Marcos-vp/TFG/Partes/Garra/Garra.FCStd

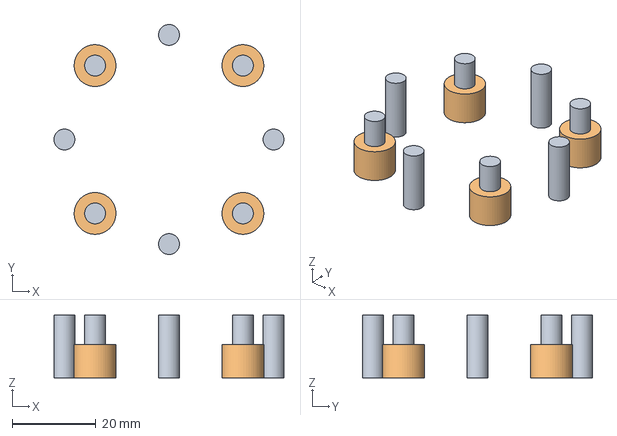
[picture p88: CAD file, 2018-09-13]
Partes/Garra/Garra.FCStd
55.0 x 55.0 x 15.0 mm
Taladro001
Taladrogrande001
