Marcos-vp/TFG/Partes/gear_for_servo.STL

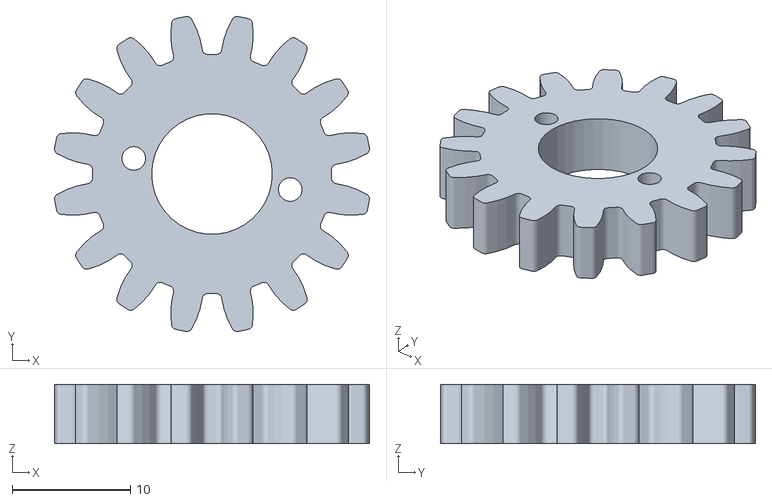
[picture p89: CAD file, 2018-09-18]
Partes/gear_for_servo.STL
26.7 x 26.7 x 5.00
