Marcos-vp/TFG/Partes/pinza 2/pinza2.FCStd

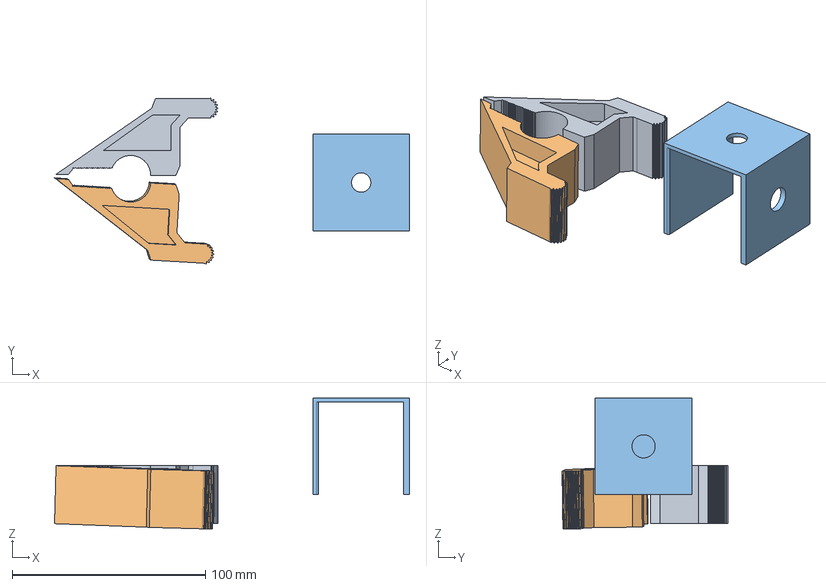
[picture p90: CAD file, 2018-09-13]
Partes/pinza 2/pinza2.FCStd
183.6 x 85.8 x 67.7 mm
Mirror of Pocket
