Marcos-vp/TFG/Partes/Pinza basica/agarre.stl

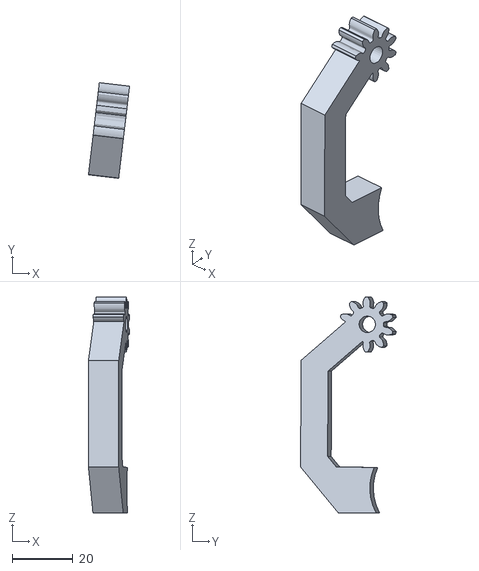
[picture p91: CAD file, 2018-10-14]
Partes/Pinza basica/agarre.stl
13.5 x 31.4 x 70.9
