Marcos-vp/TFG/Partes/Pinza final/union1.stl

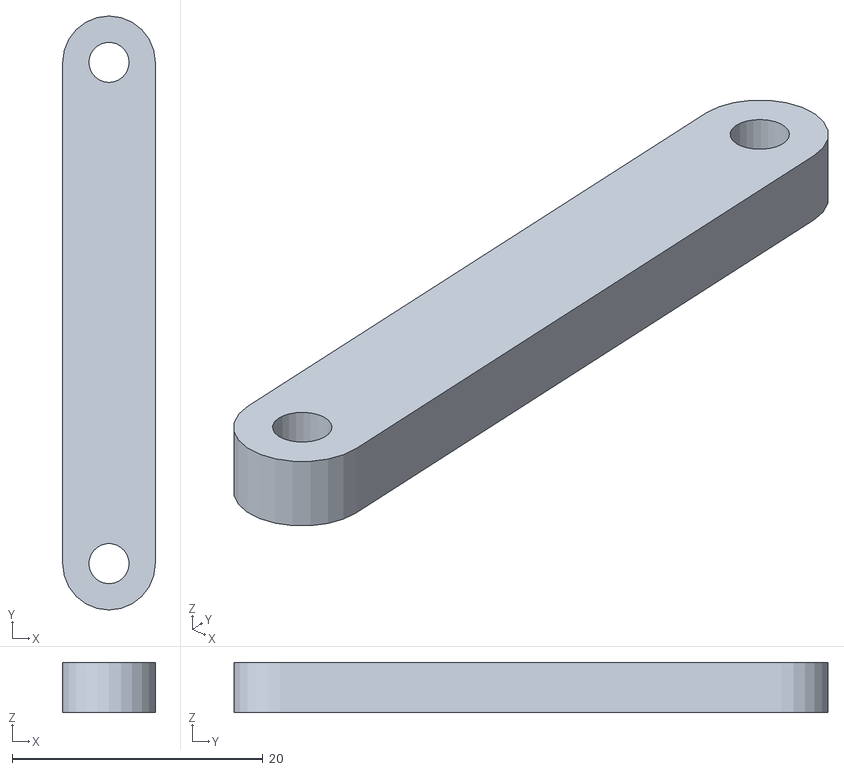
[picture p92: CAD file, 2019-10-01]
Partes/Pinza final/union1.stl
7.40 x 47.4 x 4.00
