Marcos-vp/TFG/Partes/Pinza basica/caja motor y enganche.stl

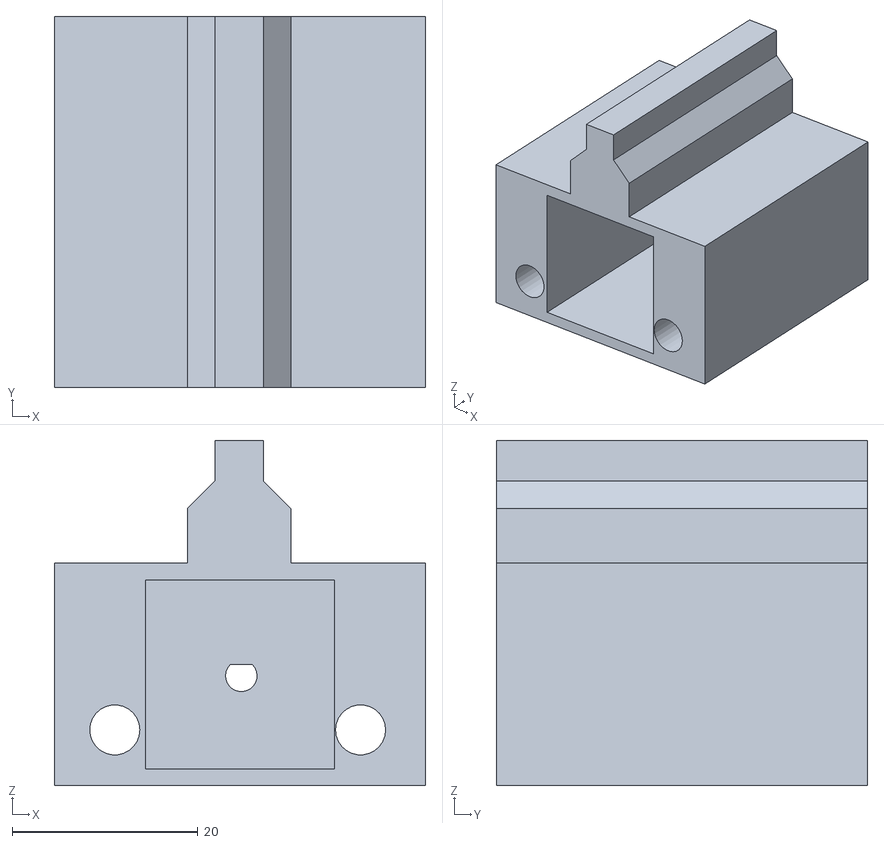
[picture p93: CAD file, 2018-10-14]
Partes/Pinza basica/caja motor y enganche.stl
40.0 x 40.0 x 37.2
