Marcos-vp/TFG/Partes/Pinza final/bridafinal.stl

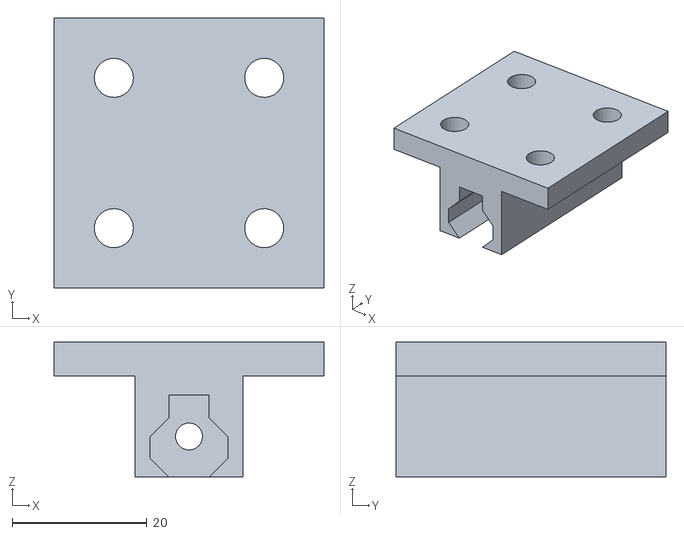
[picture p94: CAD file, 2019-10-01]
Partes/Pinza final/bridafinal.stl
40.0 x 40.0 x 20.0
