Marcos-vp/TFG/Partes/Porta_Rotulador/Herramienta Rotulador_v5.FCStd

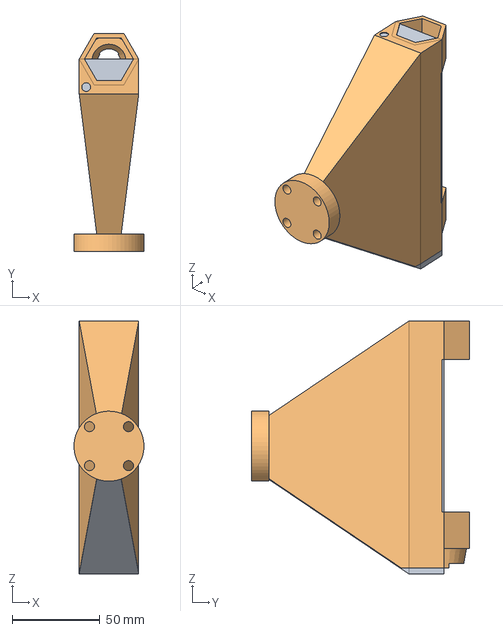
[picture p95: CAD file, 2019-06-30]
Partes/Porta_Rotulador/Herramienta Rotulador_v5.FCStd
40.0 x 124.7 x 144.5 mm
Final001
