Marcos-vp/TFG/Partes/Pinza basica/unión_brida.stl

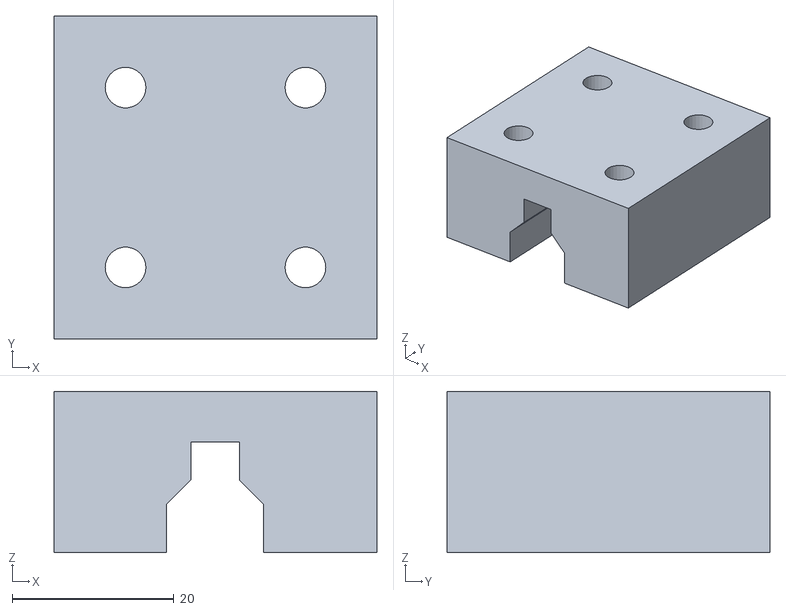
[picture p96: CAD file, 2018-10-14]
Partes/Pinza basica/unión_brida.stl
40.0 x 40.0 x 20.0
