Marcos-vp/TFG/Partes/Pinza final/cajamotor.FCStd

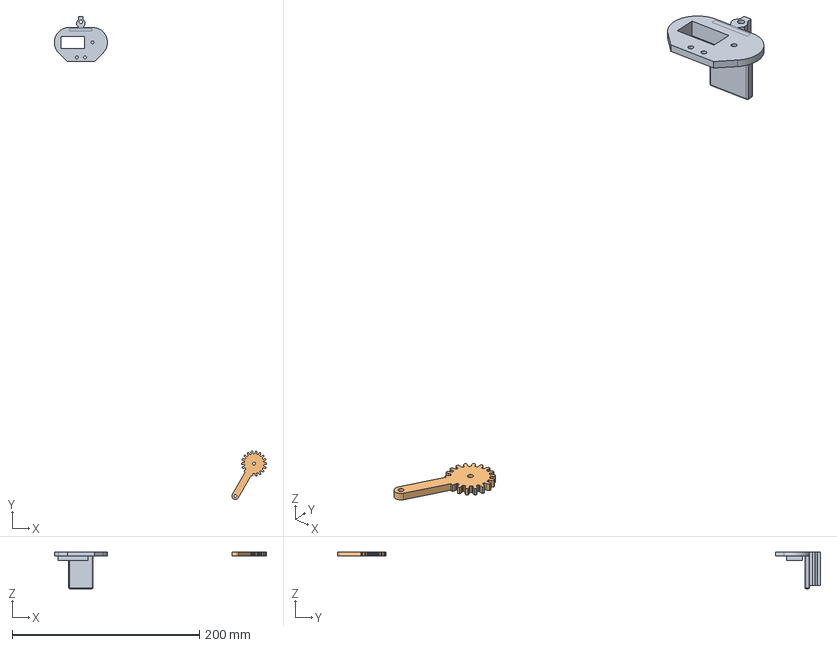
[picture p97: CAD file, 2019-10-01]
Partes/Pinza final/cajamotor.FCStd
226.9 x 516.0 x 39.0 mm
left-gear
