Marcos-vp/TFG/Partes/Pinza basica/pinza basica.FCStd

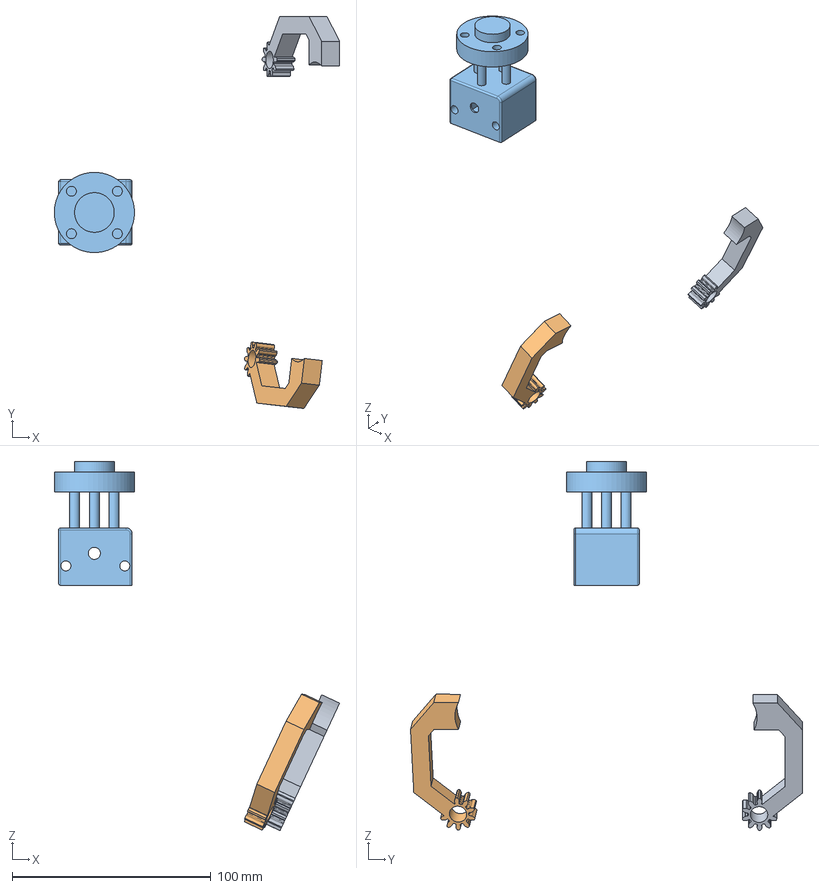
[picture p98: CAD file, 2018-10-02]
Partes/Pinza basica/pinza basica.FCStd
143.7 x 197.4 x 186.0 mm
Mirror of Pocket
Cajamotor
