Marcos-vp/TFG/Partes/Pinza final/engranajeizq.stl

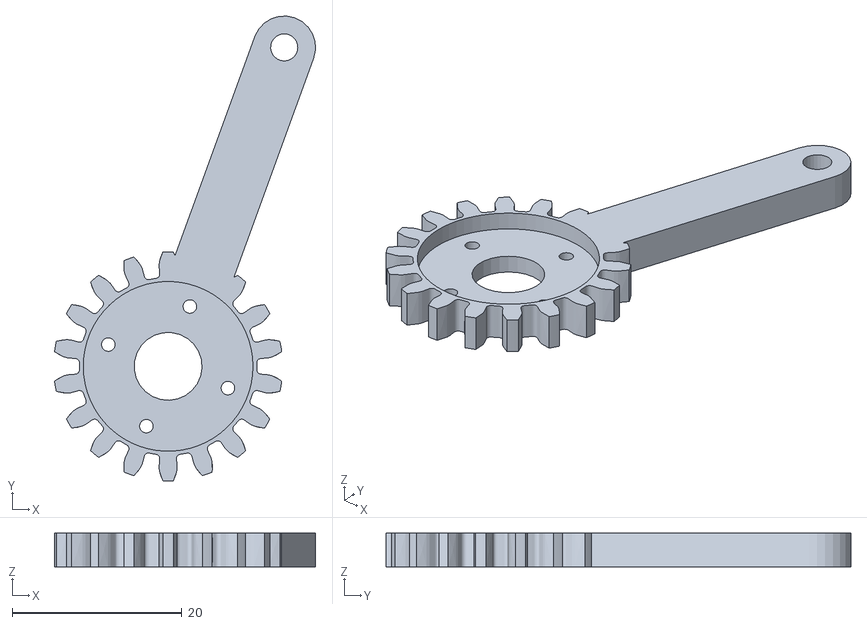
[picture p99: CAD file, 2019-10-01]
Partes/Pinza final/engranajeizq.stl
30.8 x 54.8 x 4.00
