Marcos-vp/TFG/Partes/Pinza final/cajamotor_2.stl

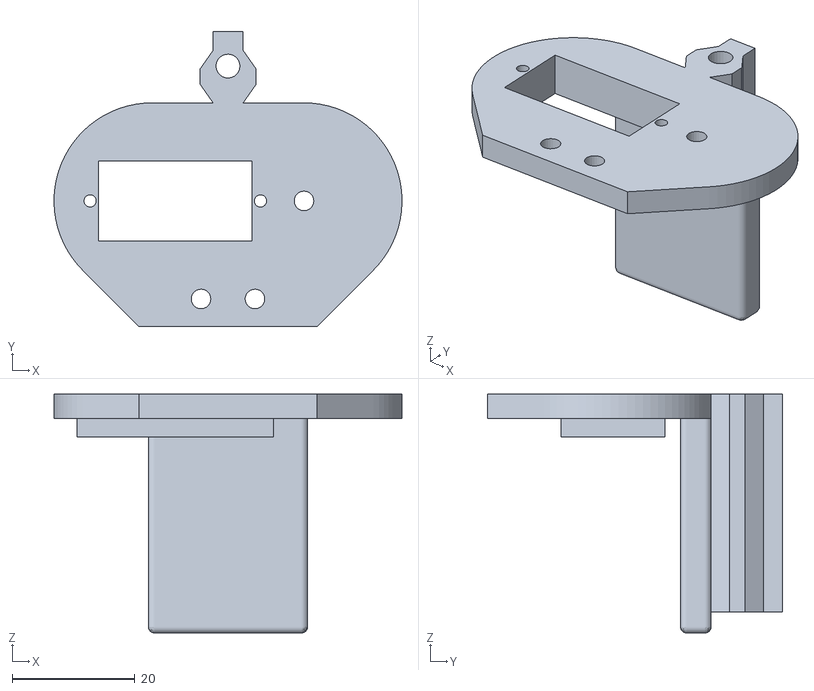
[picture p100: CAD file, 2019-10-01]
Partes/Pinza final/cajamotor_2.stl
56.8 x 48.2 x 39.0
