Marcos-vp/TFG/Partes/Pinza final/horn.FCStd

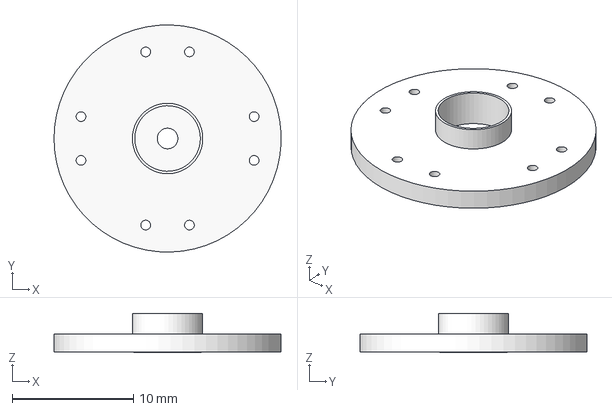
[picture p101: CAD file, 2019-10-01]
Partes/Pinza final/horn.FCStd
18.7 x 18.7 x 3.25 mm
