Marcos-vp/TFG/Partes/Pinza final/guia.stl

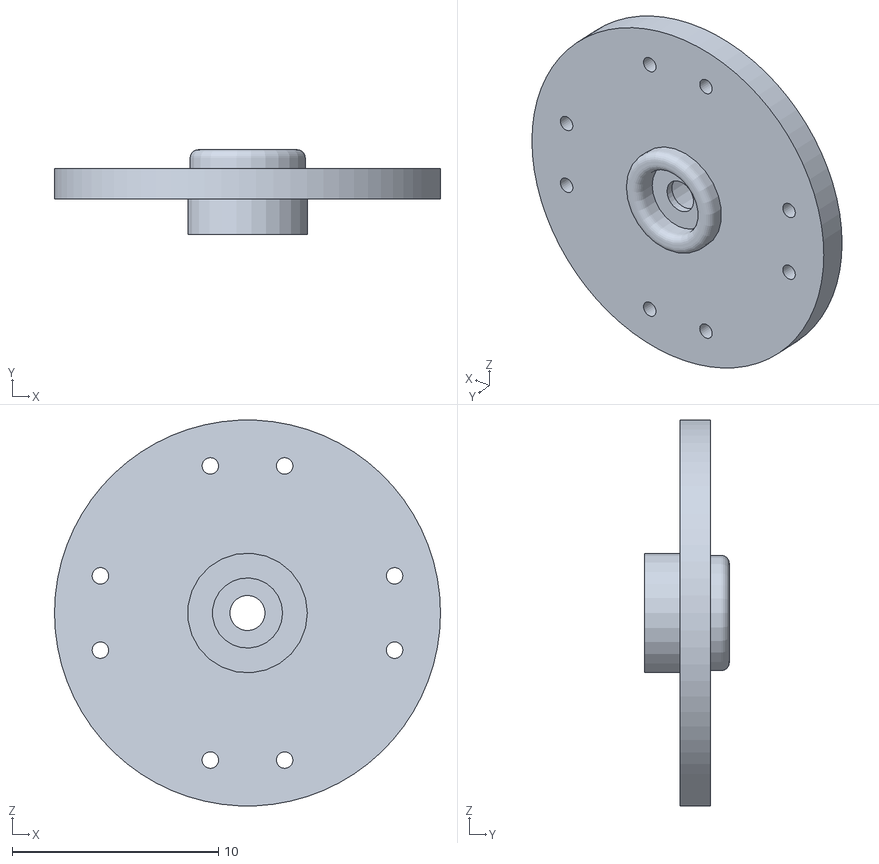
[picture p102: CAD file, 2019-10-01]
Partes/Pinza final/guia.stl
18.7 x 4.10 x 18.7
