Marcos-vp/TFG/Partes/Pinza final/guarda placa.FCStd

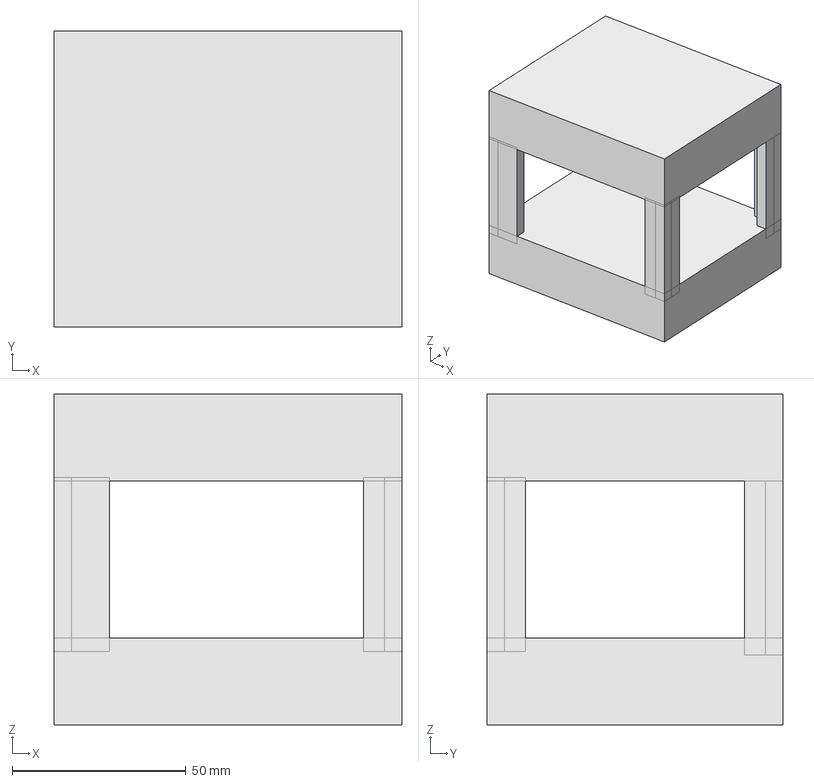
[picture p103: CAD file, 2019-10-01]
Partes/Pinza final/guarda placa.FCStd
100.0 x 85.0 x 95.0 mm
