Marcos-vp/TFG/Partes/Pinza final/Dedo1.stl

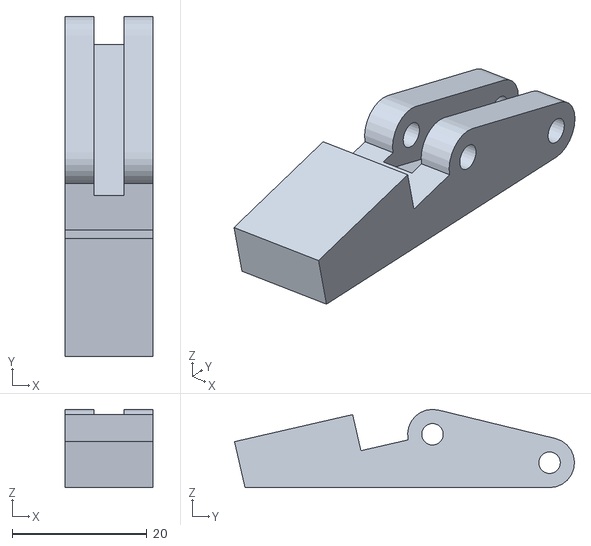
[picture p104: CAD file, 2019-10-01]
Partes/Pinza final/Dedo1.stl
13.0 x 50.5 x 11.6
