Marcos-vp/TFG/Partes/Pinza final/engranajederecho.stl

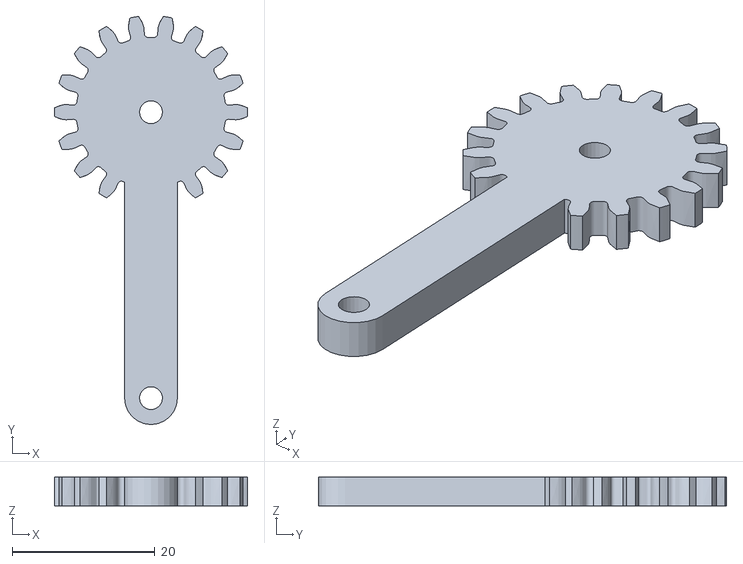
[picture p105: CAD file, 2019-10-01]
Partes/Pinza final/engranajederecho.stl
27.0 x 57.1 x 4.00
