Marcos-vp/TFG/Partes/Pinza final/base.stl

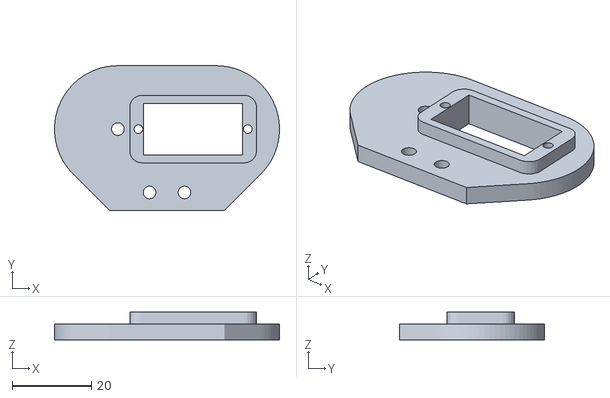
[picture p106: CAD file, 2019-10-01]
Partes/Pinza final/base.stl
56.8 x 36.5 x 7.00
