Marcos-vp/TFG/(list of files, cad)

Other CAD files:
Partes/pinza 1/pinza 1.FCStd
Partes/Pinza final/union2.stl
Partes/Pinza final/Dedo2.stl
Partes/Pinza final/cajamotor.stl
Partes/Pinza final/horn.stl
Partes/Porta_Rotulador/Herramienta Rotulador_v4_2.FCStd
