Marcos-vp/TFG/Control_de_potencia/Diseños de circuitos/Esquemático/TFG.kicad_pcb

## KiCad design Control_de_potencia/Diseños de circuitos/Esquemático/TFG.kicad_pcb (2019-06-30)

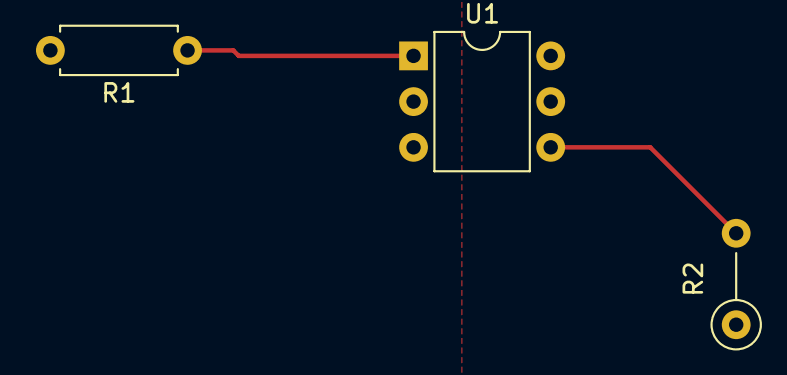
[picture p107: board TFG.kicad_pcb from above]

Board: 2 copper layers, 3 parts (0 on the bottom side), 2 nets.

Parts:
R1: 1K; R_Axial_DIN0207_L6.3mm_D2.5mm_P7.62mm_Horizontal
R2: 10K; R_Axial_DIN0207_L6.3mm_D2.5mm_P5.08mm_Vertical
U1: 4N35; DIP-6_W7.62mm

Connections:
+5V: R2.2, U1.4, U1.5
unnamed: R1.1, U1.1
