Marcos-vp/TFG/(commit log)

2018-09-18 carpeta modificada y actualizada
    [GRIPPER_ARM_1.stl, GRIPPER_ARM_2.stl, GRIPPER_ARM_3.stl, GRIPPER_MOUNT_PLATE.stl, Garra.FCStd, gear_for_servo.STL, pinza 1.FCStd, pinza basica.FCStd]
2019-06-30 actualización estado TFG
    [Herramienta Rotulador_v4_2.FCStd, Herramienta Rotulador_v5.FCStd, TFG.kicad_pcb, TFG.sch]
